southern-Soft/ETS-LORA-Test/Observation Doc/RS485_Review_Analysis.xlsx

Sheet: Defect Analysis
RS485 + ESP32-S3 — Scope-Adjusted Defect Analysis (P2P · Short Cable · 5 V)
Derived from engineering review — P2P deployment, < 10 m cable, clean 5 V supply
ID | Defect / Issue | Root Cause | Recommended Fix | Effort | Severity
D1 | UART0 shared with RS485 & RS232 | ESP32-S3 ROM bootloader blasts 115200 8N1 data on GPIO43/44 (UART0) at every reset. U9 (TP8485E) and U10 (MAX3232) both drive the same RX line → guaranteed bus contention. | Move RS485 to UART1 (e.g., GPIO17/18 or GPIO38/39). Keep UART0 strictly for logging. RS232 stays as DNF alternative. | Schematic rework | 🔴 MUST FIX
D2 | RT6160 VSEL strap may be wrong | If VSEL strap is mis-wired the regulator comes up at wrong voltage — RAK3112 either won't boot or runs out-of-spec. Firmware I²C write can also corrupt the setting at runtime. | Verify strap in schematic sets 3.3 V by default. Confirm on first power-up before populating module. Lock (or remove) the I²C VSEL write in firmware. | Verification | 🔴 MUST FIX
D3 | Fail-safe biasing too weak (R38/R39 = 2.2 kΩ) | Idle differential ≈ 44 mV — below ±200 mV receiver threshold. Receiver output floats → random RX bytes during idle → Modbus parser sees constant malformed frames even on 1 m cable. | Option A (best): replace TP8485E with THVD1450 (true fail-safe, ~$0.50) — drop R38/R39 entirely. Option B (cheap): change R38/R39 to 560 Ω. | 1-part swap | 🔴 MUST FIX
D4 | Auto-DE transistor circuit (Q6 + R37) too slow | NPN turn-OFF is slow. At 115200 bps last bit of last byte gets clipped. At 9600 bps marginal. Creates non-deterministic turnaround timing. | Remove Q6/R37. Drive DE+RE directly from GPIO21. Use ESP-IDF UART_MODE_RS485_HALF_DUPLEX for hardware-timed direction control. Fewer parts, zero timing ambiguity. | Schematic simplification | 🔴 MUST FIX
S1 | 120 Ω termination not selectable | Unterminated bus shows ringing even at 9600 bps on short cables. At 115200 bps over 5 m → bit errors. Fixed termination can't be disabled for bench testing. | Add 120 Ω + 0 Ω jumper (or 2-pin header) across A/B at each board. Populate at one node; leave open at the other. | 1 R + 1 jumper | 🟠 SHOULD FIX
S2 | No bus-side TVS diode | Finger-ESD strike on connector pins can kill transceiver even without long cables or surge environment. | Add SM712 (Semtech, ~$0.30) across A/B at connector entry. One part, no downside. | 1 part | 🟠 SHOULD FIX
S3 | No reverse polarity protection on DC jack | Mis-wired supply destroys board. Installers miswire connectors more than expected. | Add SS54 Schottky diode in series, or P-MOSFET ideal diode to avoid Vf drop. | 1 part | 🟠 SHOULD FIX
S4 | RS485 series resistors (R41/R42) could be higher | Current 10 Ω provides limited fault-current protection and ringing damping. | Bump to 22 Ω — better fault limiting, negligible impact on signal integrity at target baudrates. | Value change | 🟠 SHOULD FIX
S5 | No series resistors on UART0 between MCU and transceivers | If firmware misconfigures pin mux both MCU TX and transceiver can drive simultaneously — potential latch-up current. | Add 100 Ω series resistors on TX/RX between MCU pins and U9/U10. | 2 parts | 🟠 SHOULD FIX
N1 | No discrete status LEDs | WS2812 depends on firmware running correctly — useless if boot fails. No quick visual confirmation of power or RS485 activity. | Add: PWR LED on 3V3, TX LED (tied to DE or MCU TX), RX LED (tied to RO), USR LED on free GPIO. Total: 4 LEDs + 4 resistors. | 4 parts | 🟡 NICE-TO-HAVE
N2 | Missing test points | Without test points, probing signals during bring-up is difficult and risks shorts. | Add TPs for: +5V, 3V3, GND×2, A, B, DE, UART TX, UART RX. | PCB placement | 🟡 NICE-TO-HAVE
N3 | Per-pin VDD decoupling not explicit | 100 nF MLCC must be on each RAK3112 VDD pin (20, 21) within 2 mm. Missing in schematic. | Add explicit 100 nF decoupling caps on each VDD pin in schematic; enforce <2 mm in layout. | Layout discipline | 🟡 NICE-TO-HAVE
N4 | Insufficient bulk capacitance on 5 V rail | MLCCs alone don't damp LoRa TX transients (~500 mA). Voltage sag can reset MCU. | Add 47 µF tantalum or low-ESR electrolytic on +5V near buck-boost regulator input. | 1 part | 🟡 NICE-TO-HAVE
N5 | WS2812 data level marginal at 5 V supply | WS2812 needs 0.7×VDD = 3.5 V minimum HIGH on data when powered from 5 V. MCU drives 3.3 V → marginal at temp corners. | Use WS2812B-V5 (3.3 V tolerant) or power WS2812 from 3.3 V instead of 5 V. | Minor change | 🟡 NICE-TO-HAVE

Sheet: Action Checklist
RS485 + ESP32-S3 — Revised Action Checklist (Priority Order)
Set Status via dropdown in column E. Tally at bottom auto-updates.
# | Ref | Action | Effort | Status | Notes
1 | D1 | Move RS485 off UART0 → assign to UART1 (GPIO17/18 or GPIO38/39). Keep UART0 for logging only. | Schematic rework | ⏳ Pending
2 | D3 | Replace TP8485E with THVD1450 true fail-safe transceiver. Remove bias resistors R38/R39. | 1-part swap | ⏳ Pending
3 | D4 | Remove Q6+R37 auto-DE circuit. Drive DE+RE directly from GPIO21. Enable UART_MODE_RS485_HALF_DUPLEX in firmware. | Schematic simplification | ⏳ Pending
4 | D2 | Verify RT6160 VSEL strap = 3.3 V in schematic. Confirm on bench before populating MCU module. | Verification | ⏳ Pending
5 | S1 | Add selectable 120 Ω termination: 120 Ω + 0 Ω jumper / 2-pin header across A/B at each board. | 1 R + 1 jumper | ⏳ Pending
6 | S2 | Add SM712 TVS diode across A/B at RS485 connector entry for ESD protection. | 1 part | ⏳ Pending
7 | S3 | Add SS54 Schottky diode for reverse polarity protection on DC jack. | 1 part | ⏳ Pending
8 | N1 | Add 4 discrete LEDs: PWR (3V3), TX (RS485), RX (RS485), USR (free GPIO) + current-limiting resistors. | 4 parts | ⏳ Pending
9 | N2 | Add test points: +5V, 3V3, GND×2, RS485-A, RS485-B, DE, UART TX, UART RX. | PCB placement | ⏳ Pending
10 | S4 | Change R41/R42 series resistors from 10 Ω to 22 Ω for better damping. | Value change | ⏳ Pending
11 | S5 | Add 100 Ω series resistors on UART TX/RX between MCU pins and transceivers. | 2 parts | ⏳ Pending
12 | N3 | Add explicit 100 nF MLCC decoupling on each RAK3112 VDD pin (20, 21) in schematic. Enforce < 2 mm in layout. | Layout discipline | ⏳ Pending
13 | N4 | Add 47 µF bulk capacitor on +5V rail near regulator input. | 1 part | ⏳ Pending
14 | N5 | Switch WS2812 to WS2812B-V5 (3.3 V tolerant) or power from 3.3 V to fix marginal data level. | Minor change | ⏳ Pending
PROGRESS |  |  | Total Actions | 14 | 0 Done / 0 In Progress / 14 Pending

Sheet: Scope Comparison
Scope Comparison: Industrial Multi-Drop vs Your P2P Design
Requirement | Industrial Multi-Drop | Your Scope (P2P · Short · 5V)
Galvanic isolation | Mandatory | ✅ Not needed — shared/clean GND
Surge protection IEC61000 | Mandatory | ✅ Skip — short cable, no antenna
GDT / TBU devices | Recommended | ✅ Skip
Bus-side TVS diode | Mandatory | ⚠️ Still recommended (cheap)
120 Ω termination | Mandatory | ⚠️ Recommended > 115200 or > 3 m
Fail-safe biasing | Critical | 🔴 Still critical — prevents idle garbage
32-node loading math | Required | ✅ Skip — only 2 nodes
Reverse polarity on DC | Mandatory | ⚠️ Still recommended
PTC fuse | Mandatory | ✅ Optional for prototype
Conformal coating | Required (outdoor/harsh) | ✅ Skip — unless outdoor
24 V industrial input |  | ✅ Skip — 5 V clean supply
Multi-drop topology math | Required | ✅ Skip — P2P only
