southern-Soft/ETS-LORA-Test/Schematic/SCH_Schematic1_2026-05-03.pdf

# USB_D+GND

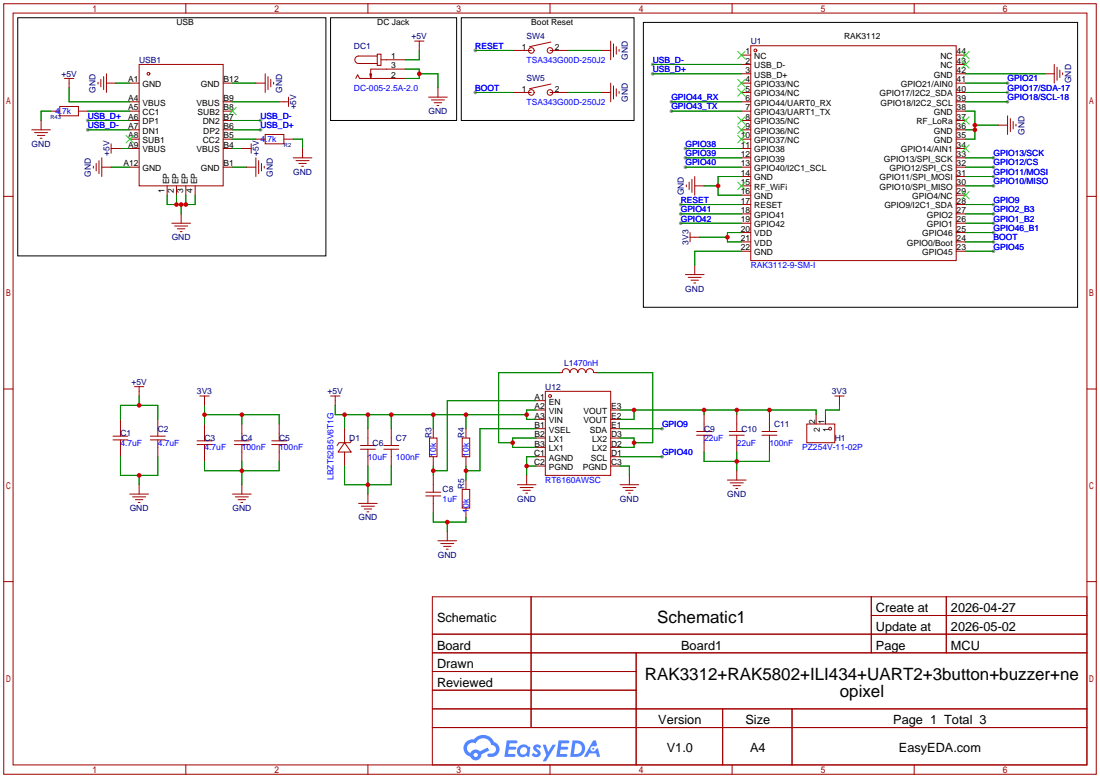
[picture p1: page 1]

Schematic | Schematic1 | Create at | 2026-04-27

Update at | 2026-05-02

Board | Board1 | Page | MCU
Drawn | | RAK3312+RAK5802+ILI434+UART2+3button+buzzer+ne opixel Reviewed

Version | Size | Page 1 Total 3
V1.0 | A4 | EasyEDA.com

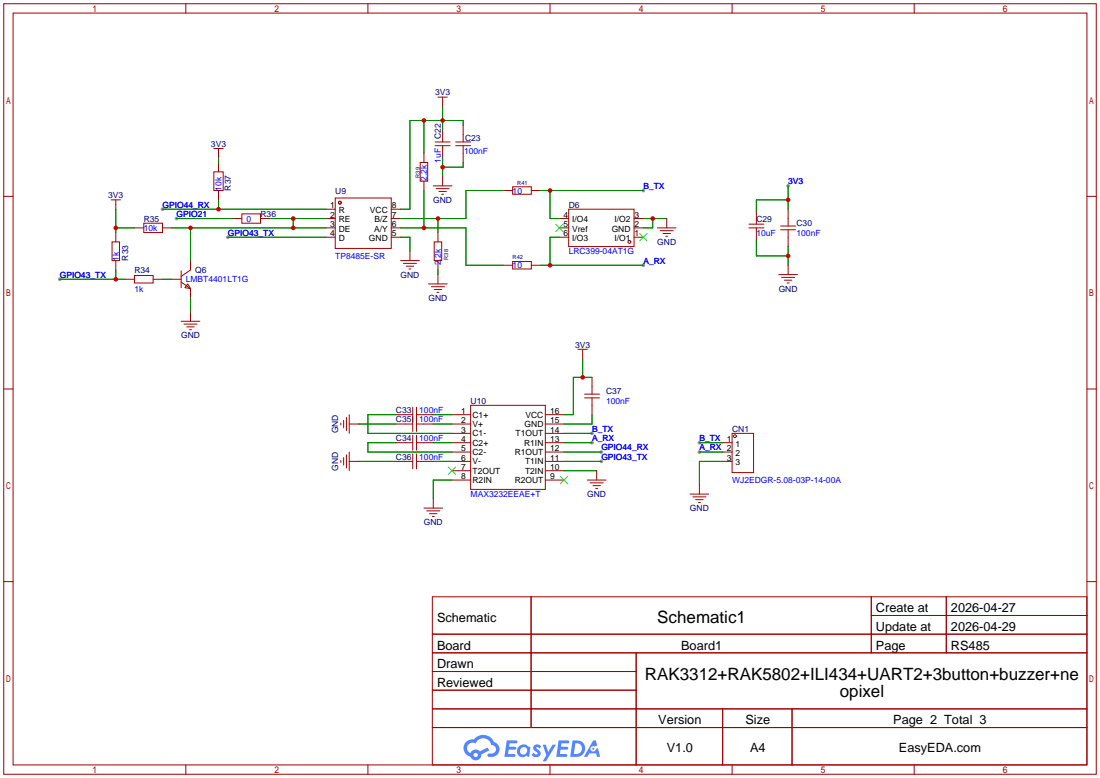
[picture p2: page 2]

Schematic | Schematic1 | Create at | 2026-04-27

Update at | 2026-04-29

Board | Board1 | Page | RS485
Drawn | | RAK3312+RAK5802+ILI434+UART2+3button+buzzer+ne opixel Reviewed

# GNDGPIO⁴⁵

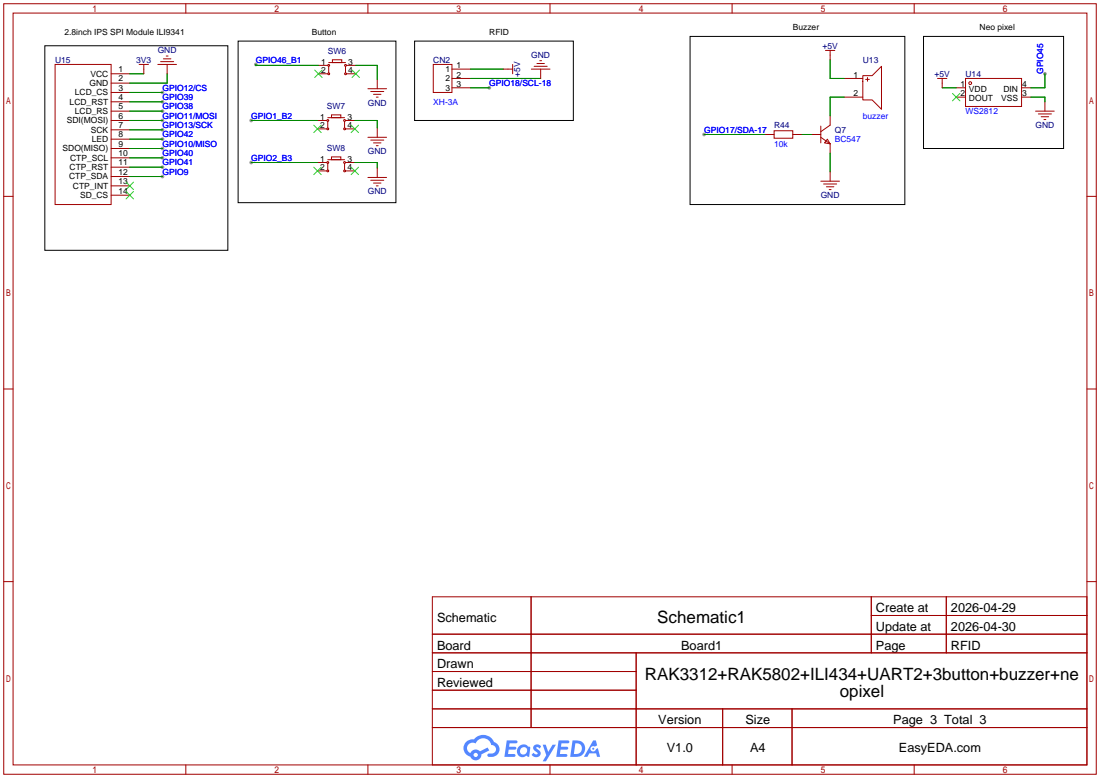
[picture p3: page 3]

Schematic | Schematic1 | Create at | 2026-04-29

Update at | 2026-04-30

Board | Board1 | Page | RFID
Drawn | | RAK3312+RAK5802+ILI434+UART2+3button+buzzer+ne opixel Reviewed
